MahmoudH-22/Smart_Home/docs/reports/fig/c_xray.png

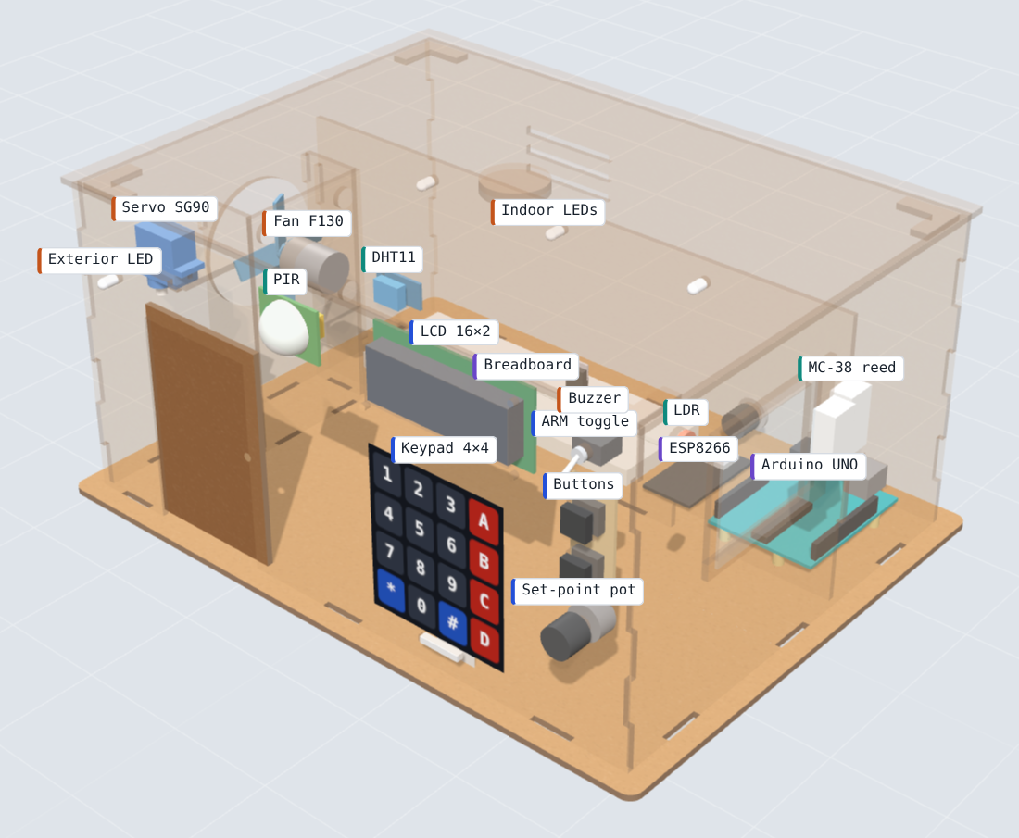
docs/reports/fig/c_xray.png
