MahmoudH-22/Smart_Home/docs/design/smart_home_3d.html

MCT331s · Mechatronic System Integration · Project 1

# Smart Home Prototype

3 mm MDF laser-cut · 300 × 220 mm footprint · Arduino UNO

Team: Mahmoud Hisham 2400844 · Ziad Hany 2301401 · Ahmed Hany 2400311 · Moatasem Mohamed 2400732

A · Gable roof (hinged) B · Flat lid · chosen

ISO FRONT BACK LEFT RIGHT TOP

Dimensions Labels X-ray Open roof Ortho

Explode

Isometric

### LCD 16×2 I2C 0x27

Code ––––Default code 1234, then #

### Security PIR · MC-38 · buzzer

Security mode (toggle)Disarmed

Window (MC-38)Closed

Motion near the doorWalk past

AlarmMute / reset

### Lighting & climate LDR · DHT11 · pot

Ambient light (LDR)70 %

Indoor light overrideAuto

Room temperature (DHT11)26 °C

Fan set-point (knob)30 °C

### System state

### Event log alerts → recipients
