MahmoudH-22/Smart_Home/docs/reports/fig/c_exploded.png

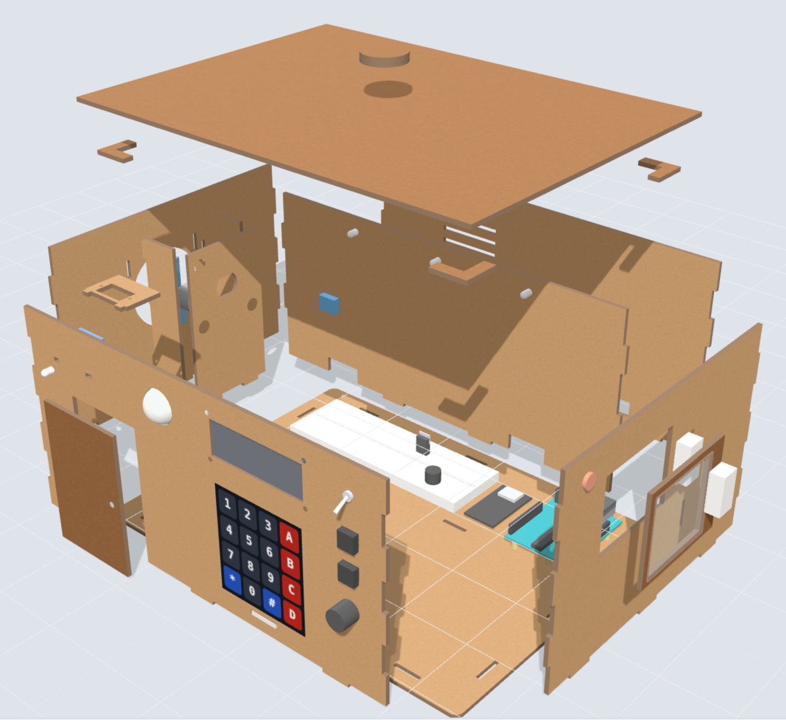
docs/reports/fig/c_exploded.png
