MahmoudH-22/Smart_Home/docs/reports/fig/c_front.png

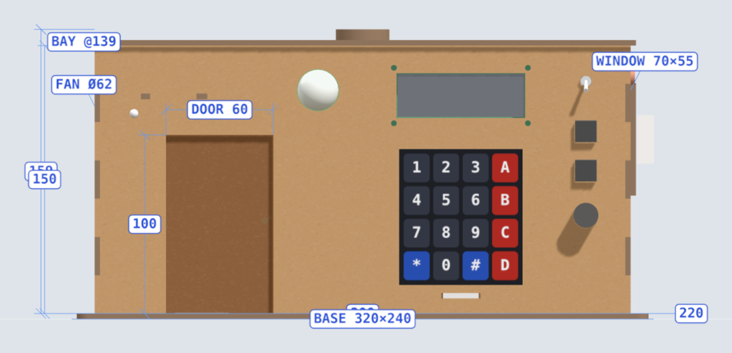
docs/reports/fig/c_front.png
