MahmoudH-22/Smart_Home/docs/reports/fig/c_iso.png

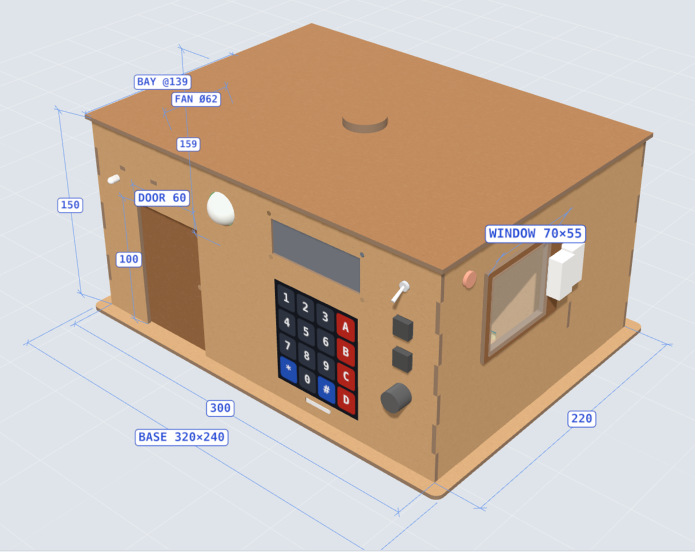
docs/reports/fig/c_iso.png
