MahmoudH-22/Smart_Home/docs/reports/fig/c_left.png

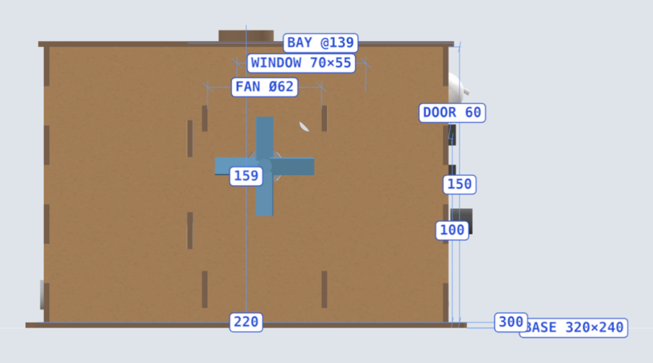
docs/reports/fig/c_left.png
