MahmoudH-22/Smart_Home/docs/reports/fig/c_right.png

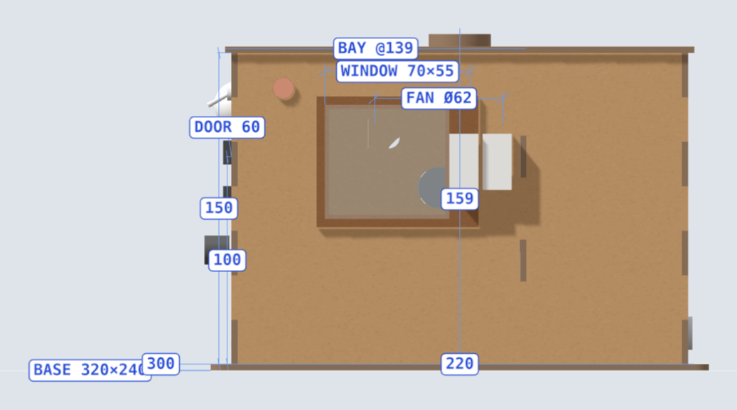
docs/reports/fig/c_right.png
