MahmoudH-22/Smart_Home/docs/reports/fig/c_top.png

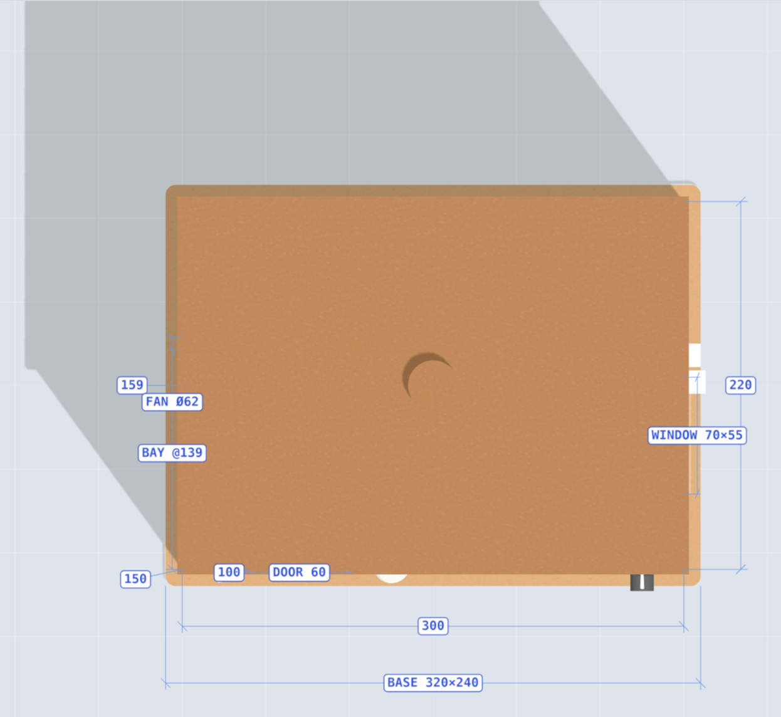
docs/reports/fig/c_top.png
