MahmoudH-22/Smart_Home/docs/BOM.md

# Bill of Materials

Classified as the report requires: **Sensor**, **Actuator**, **Information processing**, **Mechanical**.
Prices are in EGP from the purchase receipt (20 Oct 2026).

## Bought

| # | Item | Class | Function | Qty | Unit (EGP) | Total (EGP) |
|---|---|---|---|---|---|---|
| 1 | Arduino UNO R3 (clone) | Information processing | Main controller | 1 | 339.00 | 339.00 |
| 2 | LCD 16×2 blue + I2C module (soldered) | Information processing | Status display | 1 | 130.00 | 130.00 |
| 3 | Matrix keypad 4×4 | Sensor (user input) | Door code entry | 1 | 29.90 | 29.90 |
| 4 | MC-38 magnetic door/window switch (NC) | Sensor | Window open/closed | 1 | 59.90 | 59.90 |
| 5 | DHT11 temperature/humidity module | Sensor | Room temperature | 1 | 49.00 | 49.00 |
| 6 | LDR photoresistor 10 mm | Sensor | Ambient light level | 1 | 11.90 | 11.90 |
| 7 | Toggle switch 3-pin, 2-position | Sensor (user input) | Security ARM switch | 1 | 11.90 | 11.90 |
| 8 | Push button 12×12×7.3 mm (4-pin) | Sensor (user input) | Light override / alarm mute | 3 | 3.25 | 9.75 |
| 9 | Omron button cap 12×12 (black) | Mechanical | Button caps | 3 | 1.75 | 5.25 |
| 10 | Servo SG90 180° | Actuator | Door motion | 1 | 80.00 | 80.00 |
| 11 | DC motor 5 V F130 | Actuator | Fan | 1 | 12.90 | 12.90 |
| 12 | Plastic propeller 4 blades 56 mm | Mechanical | Fan blade | 1 | 18.90 | 18.90 |
| 13 | Buzzer 5 V | Actuator | Alarm sound | 1 | 7.90 | 7.90 |
| 14 | White LED 5 mm | Actuator | Indoor + exterior lights | 10 | 0.47 | 4.70 |
| 15 | Resistor 220 Ω ¼ W | Electrical | LED current limit | 10 | 0.20 | 2.00 |
| 16 | Breadboard 830 tie-point (split rails) | Electrical | Prototype wiring | 1 | 40.00 | 40.00 |
| 17 | Breadboard jumper kit (140, U-shape) | Electrical | Short breadboard links | 1 | 54.90 | 54.90 |
| 18 | Jumper wires 40 cm female-female | Electrical | Off-board wiring | 40 | 1.75 | 70.00 |
| 19 | Jumper wires 20 cm male-male | Electrical | Breadboard wiring | 40 | 0.78 | 31.20 |
| 20 | Heat-shrink bag (164 pcs) | Electrical | Insulating joints | 1 | 64.90 | 64.90 |
| 21 | Component storage box 230×160×60 | - | Parts storage | 1 | 94.90 | 94.90 |
| | **Receipt total** | | | | | **1,128.90** |

## Structure (laser-cut)

| Item | Material | Qty |
|---|---|---|
| House panels (19 parts, 14 designs) | 3 mm MDF, 2 sheets 600×400 | 2 sheets |
| Wood glue | PVA | 1 |

## Still to buy

| Item | Class | For | Qty |
|---|---|---|---|
| PIR motion sensor HC-SR501 | Sensor | Exterior light on motion | 1 |
| Potentiometer 10 kΩ (panel, with knob) | Sensor (user input) | Fan set-point | 1 |
| Resistor 10 kΩ | Electrical | LDR voltage divider | 2 |
| TIP120 (or 2N2222) + 1N4007 + 1 kΩ | Electrical (driver) | Fan motor driver | 1 set |
| PCF8574 I2C I/O module | Information processing | Keypad on the I2C bus (frees 8 pins) | 1 |
| ESP8266 (ESP-01 + adapter, or NodeMCU) | Information processing | Phone alerts (Wi-Fi) | 1 |
| 5 V 2 A adapter + panel DC jack | Power | Servo + fan supply | 1 |
| M3 brass standoffs + screws | Mechanical | Arduino / LCD mounting | 4 + 8 |
| Mini hinge 25 mm | Mechanical | Window | 1 |
| 2 mm clear acrylic (optional) | Mechanical | Window glazing | 62×57 mm |
| Veroboard | Electrical | Final soldered wiring | 1 |
