MahmoudH-22/Smart_Home/hardware/laser_dxf/parts/fanplate_x1.dxf

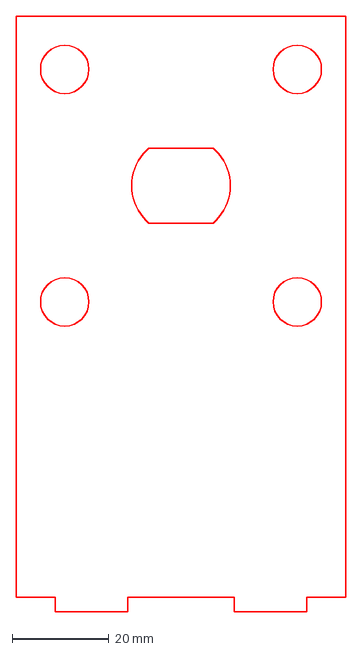
[picture p16: CAD file, 2026-10-25]
hardware/laser_dxf/parts/fanplate_x1.dxf
68.0 x 123.0 mm
