MahmoudH-22/Smart_Home/hardware/laser_dxf/sheet_1_of_2_600x400.dxf

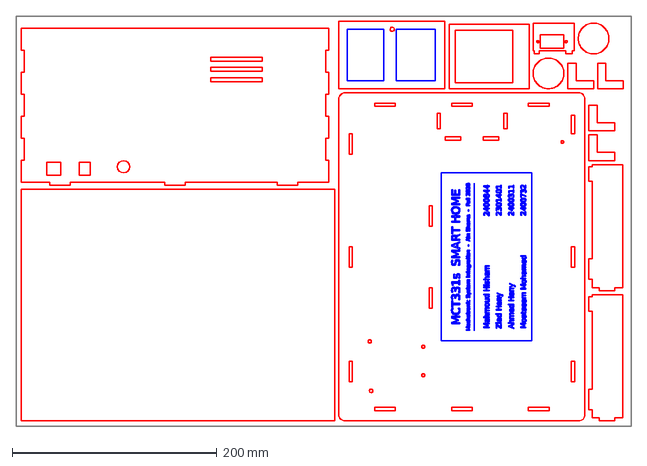
[picture p17: CAD file, 2026-10-25]
hardware/laser_dxf/sheet_1_of_2_600x400.dxf
600.0 x 400.0 mm
