MahmoudH-22/Smart_Home/hardware/laser_dxf/parts/lid_x1.dxf

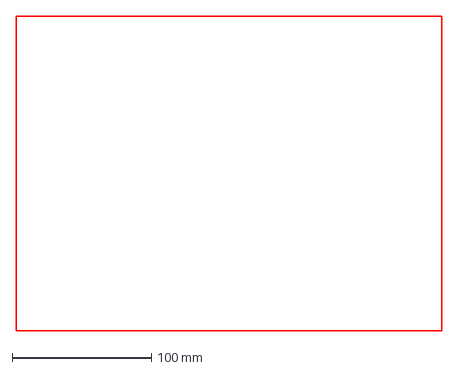
[picture p18: CAD file, 2026-10-25]
hardware/laser_dxf/parts/lid_x1.dxf
306.0 x 226.0 mm
