MahmoudH-22/Smart_Home/hardware/laser_dxf/sheet_2_of_2_600x400.dxf

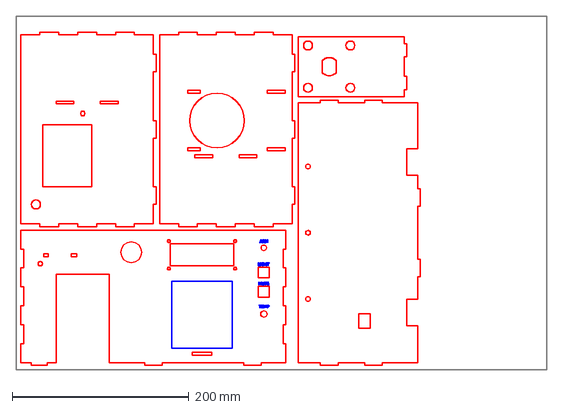
[picture p19: CAD file, 2026-10-25]
hardware/laser_dxf/sheet_2_of_2_600x400.dxf
600.0 x 400.0 mm
