MahmoudH-22/Smart_Home/hardware/laser_dxf/parts/right_x1.dxf

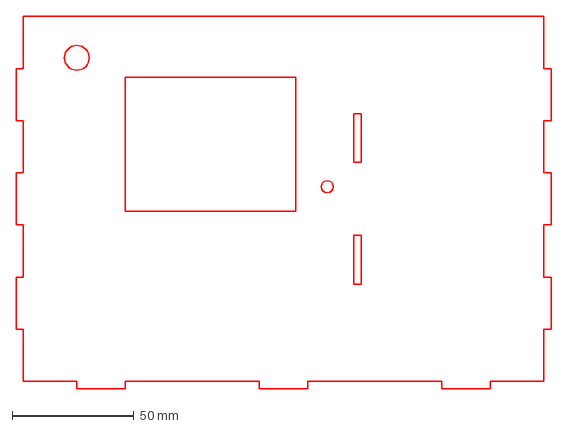
[picture p20: CAD file, 2026-10-25]
hardware/laser_dxf/parts/right_x1.dxf
220.0 x 153.0 mm
