MahmoudH-22/Smart_Home/hardware/laser_dxf/parts/shelf_x1.dxf

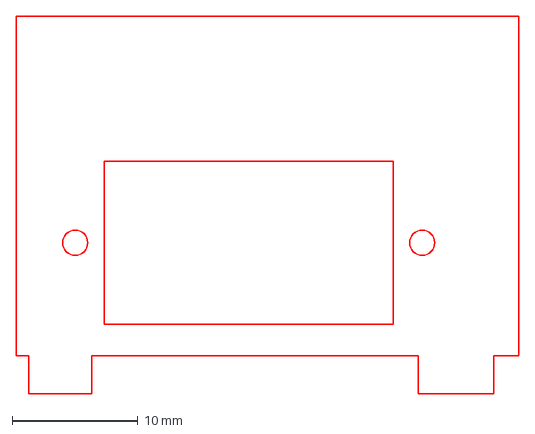
[picture p21: CAD file, 2026-10-25]
hardware/laser_dxf/parts/shelf_x1.dxf
40.0 x 30.0 mm
