MahmoudH-22/Smart_Home/hardware/laser_dxf/parts/door_x1.dxf

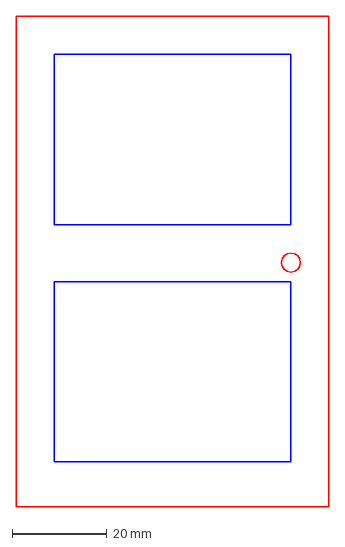
[picture p22: CAD file, 2026-10-25]
hardware/laser_dxf/parts/door_x1.dxf
66.0 x 103.5 mm
