MahmoudH-22/Smart_Home/hardware/laser_dxf/parts/locator_x4.dxf

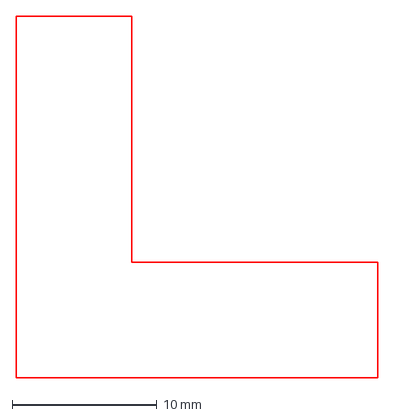
[picture p23: CAD file, 2026-10-25]
hardware/laser_dxf/parts/locator_x4.dxf
25.0 x 25.0 mm
