MahmoudH-22/Smart_Home/hardware/laser_dxf/parts/partition_x1.dxf

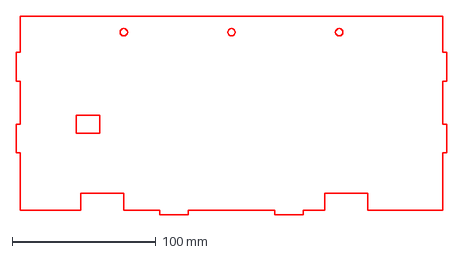
[picture p24: CAD file, 2026-10-25]
hardware/laser_dxf/parts/partition_x1.dxf
300.0 x 138.0 mm
