MahmoudH-22/Smart_Home/hardware/laser_dxf/parts/fanrib_x2.dxf

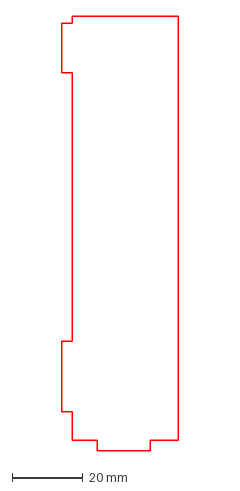
[picture p25: CAD file, 2026-10-25]
hardware/laser_dxf/parts/fanrib_x2.dxf
33.0 x 123.0 mm
