MahmoudH-22/Smart_Home/hardware/laser_dxf/parts/knob_x2.dxf

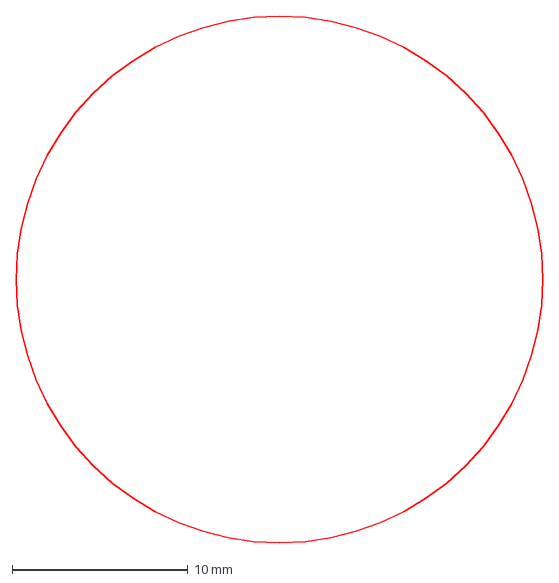
[picture p26: CAD file, 2026-10-25]
hardware/laser_dxf/parts/knob_x2.dxf
30.0 x 30.0 mm
