MahmoudH-22/Smart_Home/hardware/laser_dxf/parts/sash_x1.dxf

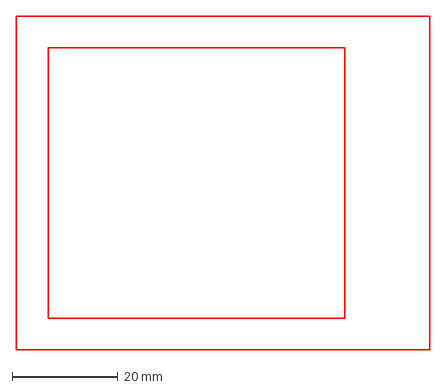
[picture p27: CAD file, 2026-10-25]
hardware/laser_dxf/parts/sash_x1.dxf
78.0 x 63.0 mm
