MahmoudH-22/Smart_Home/hardware/laser_dxf/parts/back_x1.dxf

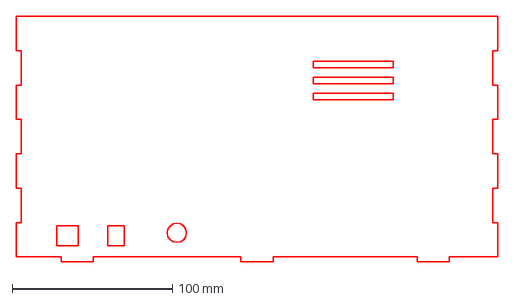
[picture p30: CAD file, 2026-10-25]
hardware/laser_dxf/parts/back_x1.dxf
300.0 x 153.0 mm
