MahmoudH-22/Smart_Home/hardware/laser_dxf/parts/base_x1.dxf

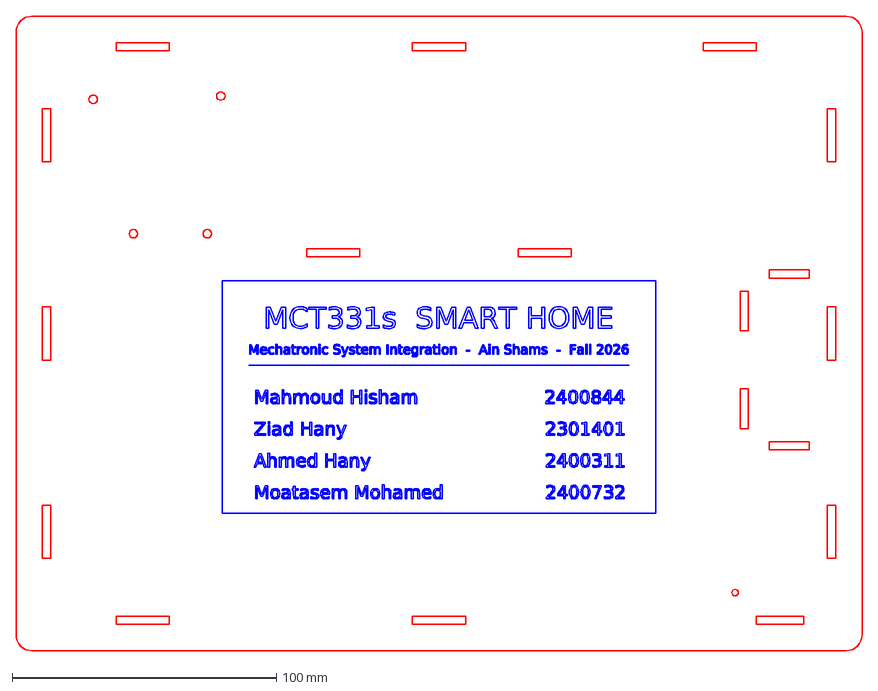
[picture p31: CAD file, 2026-10-25]
hardware/laser_dxf/parts/base_x1.dxf
320.0 x 240.0 mm
