MahmoudH-22/Smart_Home/hardware/wiring/Wiring_Guide.pdf

## MCT331s · Mechatronic System Integration · Project 1

# دليل التوصيل — Home Smart

كل التوصيالت اليل عملناها لحد دلوقيت، خطوة بخطوة، بالصور ورقم كل pin.

اليل في الدليل: الـ Buzzer لوحده ← الشاشة LCD لوحدها ← التوصيل الكامل )Buzzer + LCD + حساس الشباك -38MC).

Mahmoud Hisham | 2400844
Ziad Hany | 2301401
Ahmed Hany | 2400311
Moatasem Mohamed | 2400732

Ain Shams University · Faculty of Engineering · 21 Oct 2026

## 0( قبل ما تبدأ

### الحاجات المطلوبة

USB | كابل | + Arduino UNO

Breadboard 830

I2C backpack | عليها | LCD 16×2 | شاشة

Buzzer 5V

حساس شباك مغناطييس-38MC( قطعتني: حساس بسلكني +

مغناطيس(

سلوك M-M :jumper( ذكر-ذكر( و F-F( أنىث-أنىث(

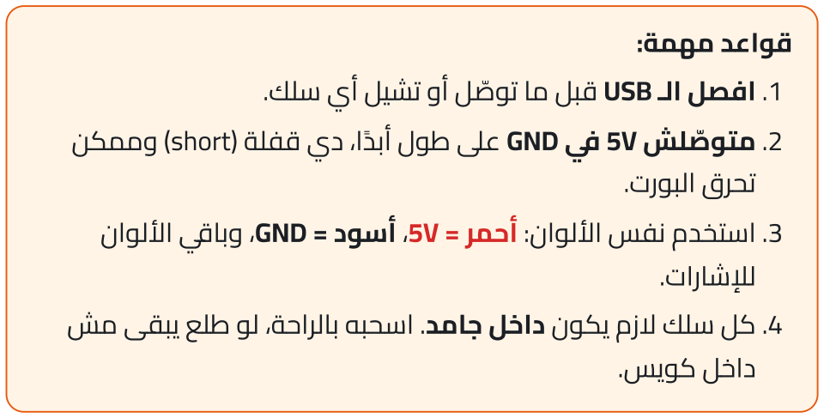
[picture p32: figure]
قواعد مهمة:; تحرق البورت.; لإلشارات.; داخل كويس.

.1 افصل الـ USB قبل ما توّصل أو تشيل أي سلك.

.2 متوّصلشV5 في GND عىل طول أبًدا، دي قفلة )short )وممكن

.3 استخدم نفس األلوان: أحمر = V،5 أسود = GND، وباقي األلوان

.4 كل سلك الزم يكون داخل جامد. اسحبه بالراحة، لو طلع يبقى مش

### إزاي تعمل سلك Female-Male

رجول الشاشة ذكر واألردوينو أنىث، فمحتاج سلك ذكر من ناحية وأنىث من

الناحية التانية. لو معندكش، د ّخل سلك M-M جوه طرف سلك F-F، فيبقى

عندك سلك ذكر-أنىث. لّف عىل الوصلة شوية رشيط عشان متف ّكش.

اقرا مكان الخرم كده: الحرف هو الصف )j–a )والرقم هو العمود )1–

30(. يعين 17j = صف j، عمود .17 و − Rail = الصف األزرق اليل تحت.

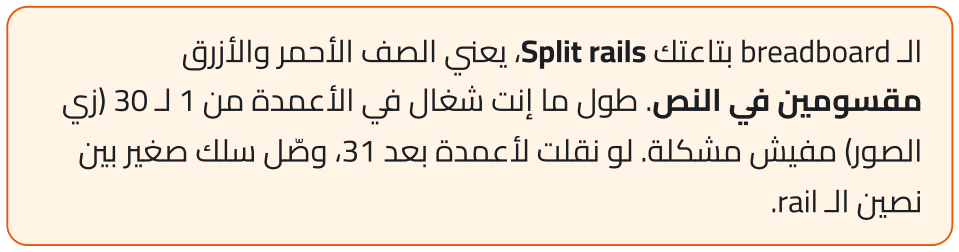
[picture p33: figure]
نصني الـ rail.

الـ breadboard بتاعتك rails Split، يعين الصف األحمر واألزرق

مقسومني في النص. طول ما إنت شغال في األعمدة من 1 لـ 30 )زي

الصور( مفيش مشكلة. لو نقلت ألعمدة بعد ،31 وّصل سلك صغري بني

## 0( الـ breadboard متوصلة من جوه إزاي

أهم حاجة تفهمها قبل أي توصيل: الخرمني اليل في نفسالعمود )في نفس النص( متوصلني ببعض، فلو حطيت رجل قطعة وسلك في نفس العمود يبقوا

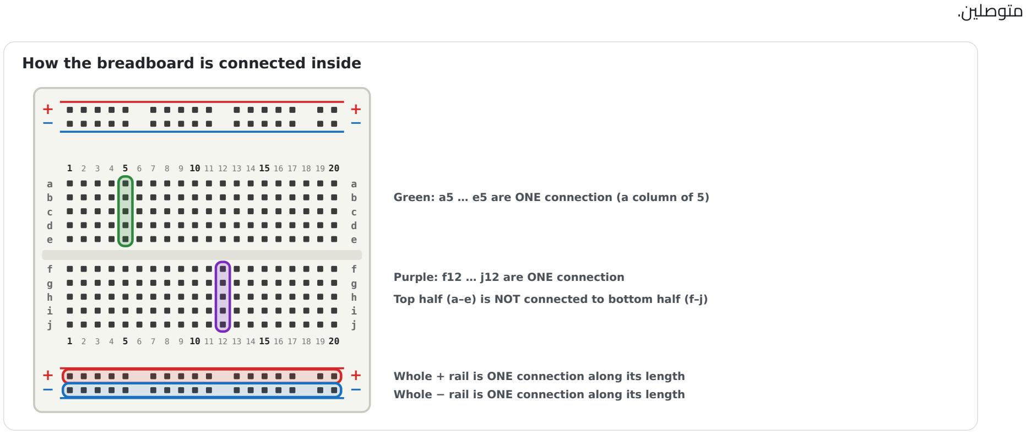
[picture p34: figure]
متوصلني.; How the breadboard is connected inside; Purple: f12 … j12 are ONE connection

Green: a5 … e5 are ONE connection (a column of 5)

Top half (a–e) is NOT connected to bottom half (f–j)

Whole + rail is ONE connection along its length Whole − rail is ONE connection along its length

## 1( الـ Buzzer لوحده

## 1) Buzzer alone — D8 → Buzzer(+) , Buzzer(−) → GND

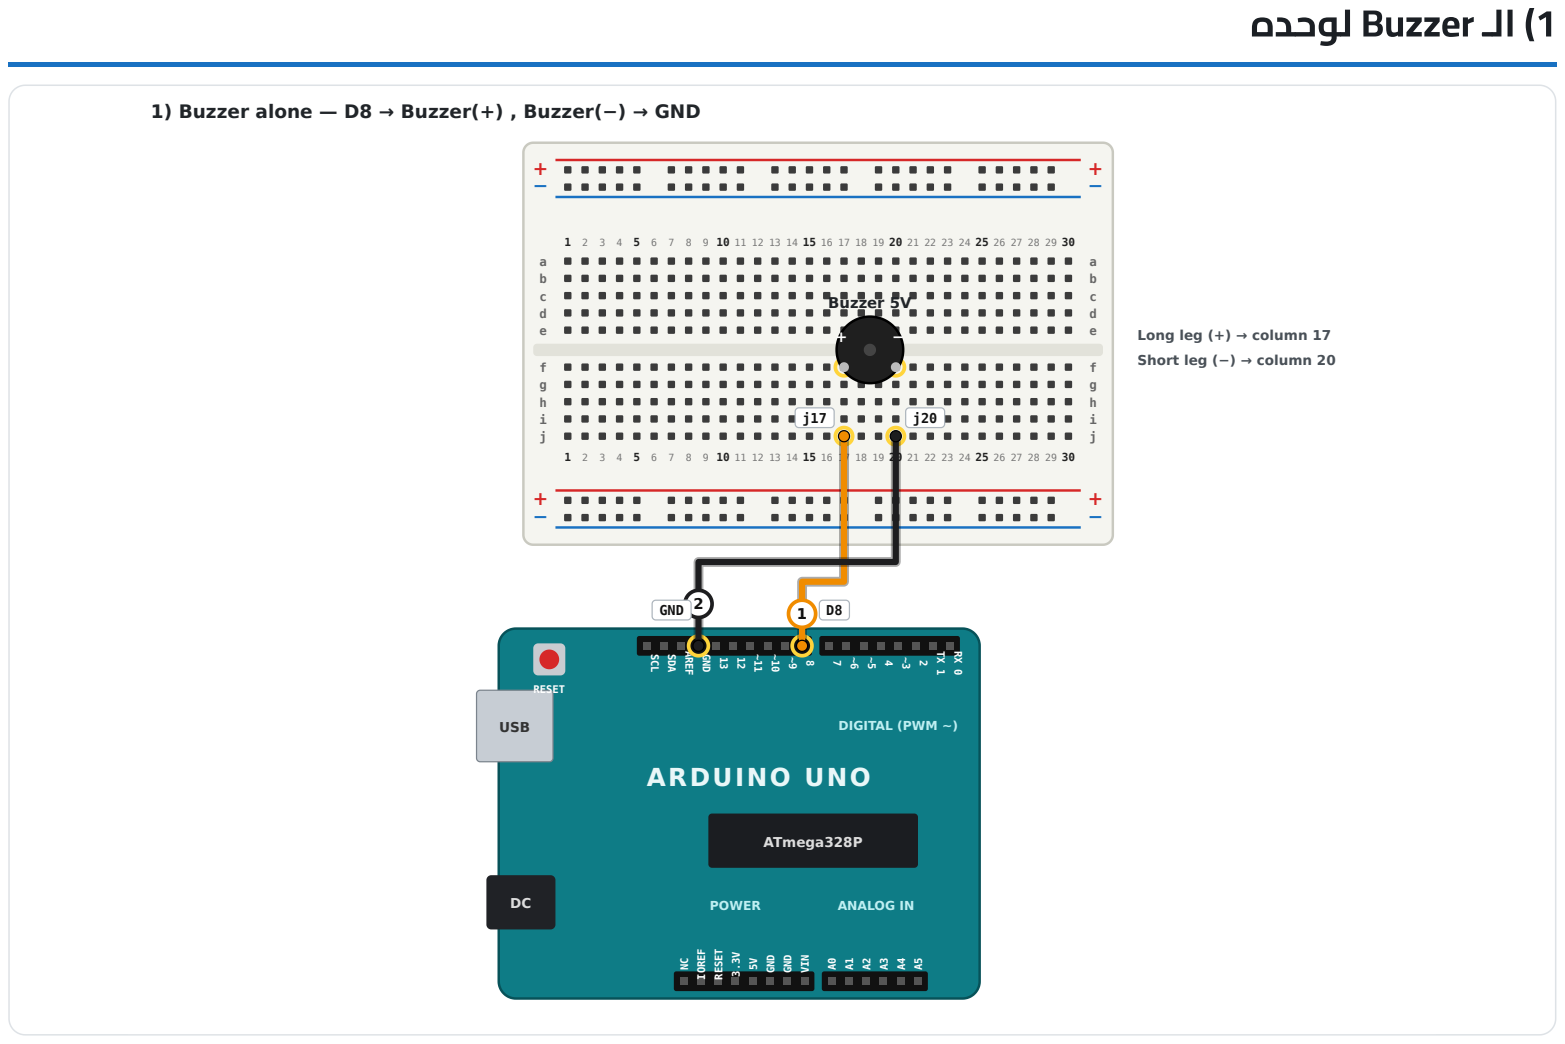
[picture p35: page 4]
USB; ATmega328P; ARDUINO UNO; RESET; SCL; SDA; AREF; GND; IOREF; VIN; DIGITAL (PWM ~); POWER; ANALOG IN; Buzzer 5V; 2 GND

Long leg (+) → column 17
Short leg (−) → column 20

## 1( الـ Buzzer لوحده — الخطوات

### حط الـ buzzer عىل الـ breadboard

.1 بص عىل رجلني الـ buzzer: الطويلة = + والقصرية = .− وغالًبا عالمة +

مكتوبة عليه من فوق.

.2 ل الرجل الطويلة )+( في 17f، والقصرية )−( في 20f.
د ّخ

### السلوك

# من )From )إىل )To)

لون

السلك

مالحظة

## Arduino D8 1

## Breadboard 17j برتقايل

نفس العمود اليل فيه رجل

الـ + )الطويلة( بتاعة الـ

f17 في buzzer

2

## Breadboard

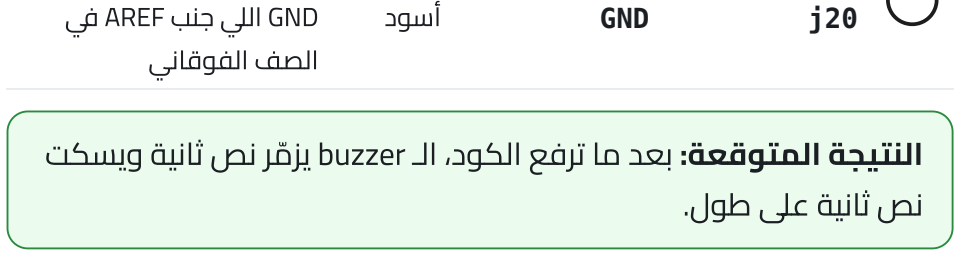
[picture p36: figure]
GND اليل جنب AREF في; الصف الفوقاني; نص ثانية عىل طول.

j20

## Arduino GND أسود

نفس العمود اليل فيه رجل

الـ − )القصرية( في 20f. الـ

النتيجة المتوقعة: بعد ما ترفع الكود، الـ buzzer يزّمر نص ثانية ويسكت

لو مش بزيّمر: اقلب رجلني الـ buzzer، واتأكد إن السلك الربتقايل في 8D

### كود التجربة

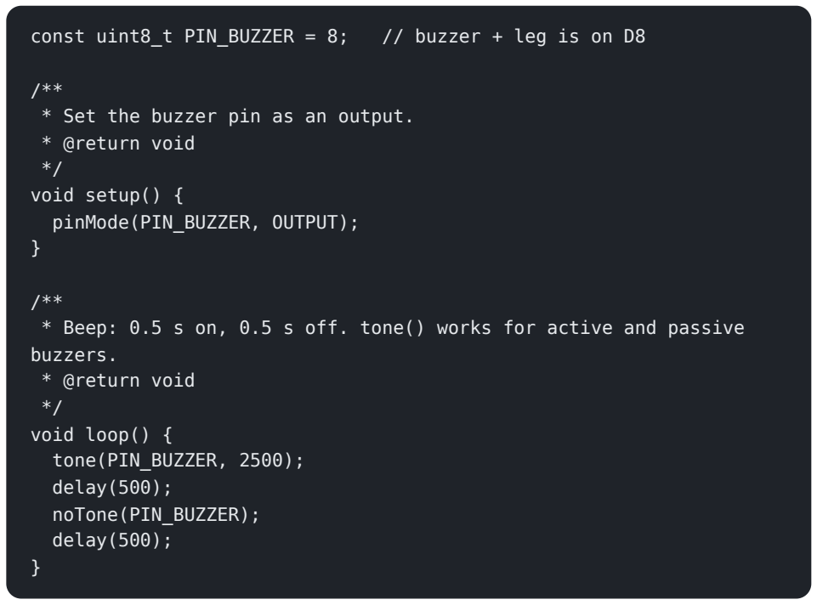
[picture p37: figure]
/** * Set the buzzer pin as an output. * @return void */ void setup() { pinMode(PIN_BUZZER, OUTPUT);; buzzers. * @return void */ void loop() { tone(PIN_BUZZER, 2500); delay(500); noTone(PIN_BUZZER); delay(500);

### const uint8_t PIN_BUZZER = 8; // buzzer + leg is on D8

### * Beep: 0.5 s on, 0.5 s off. tone() works for active and passive

## 2( الشاشة LCD لوحدها

## 2) LCD 16×2 I2C alone — GND→GND , VCC→5V , SDA→A4 , SCL→A5

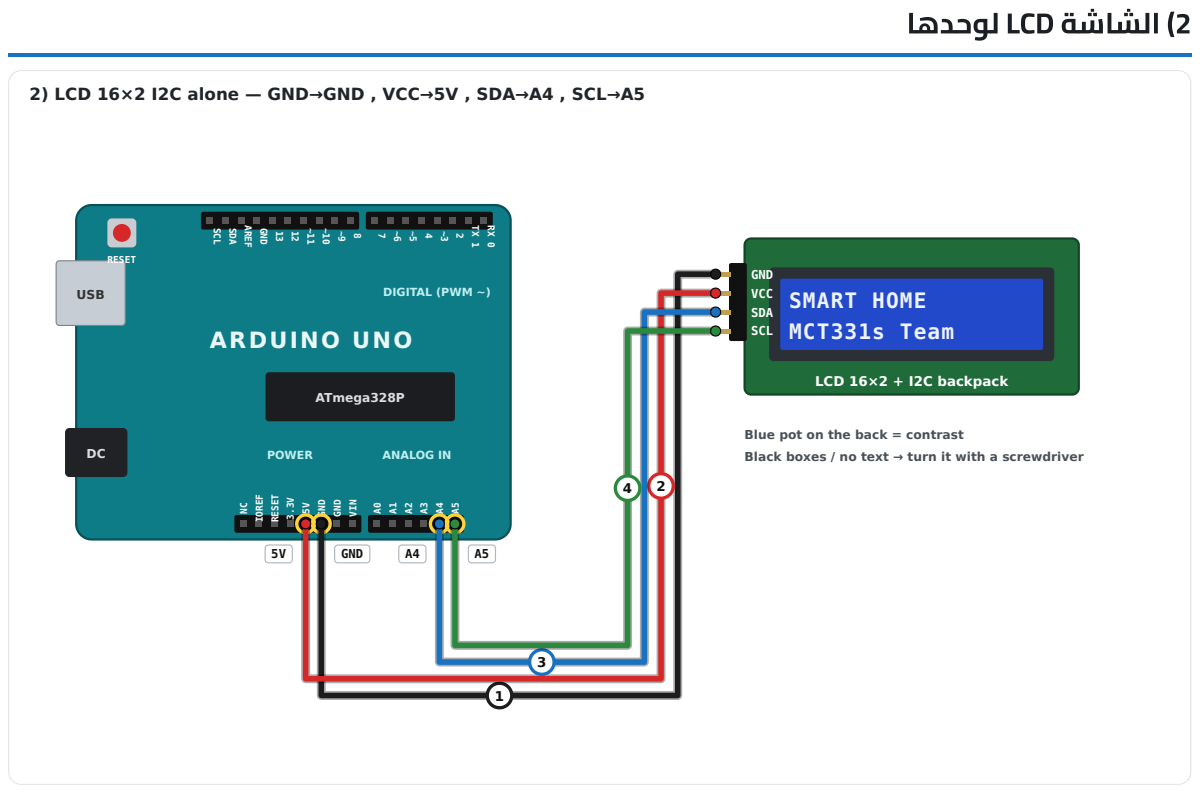
[picture p38: page 6]
USB; ATmega328P; ARDUINO UNO; RESET; SCL; SDA; AREF; GND; IOREF; VIN; DIGITAL (PWM ~); POWER; ANALOG IN; SMART HOME MCT331s Team; LCD 16×2 + I2C backpack; GND VCC SDA SCL

Blue pot on the back = contrast
Black boxes / no text → turn it with a screwdriver

## 2( الشاشة LCD لوحدها — الخطوات

الشاشة متوصلة بـ 4 سلوك بسعن طريق الـ backpack C2I( البوردة

الصغرية اليل ورا الشاشة(. الـ 4 رجول مكتوب جنبهم أساميهم.

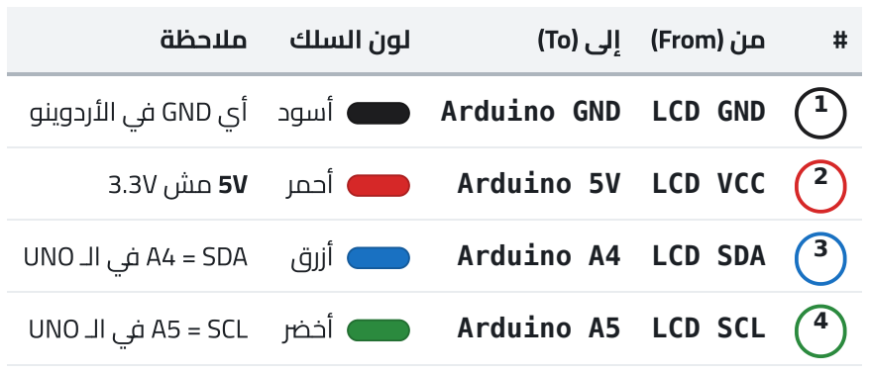
[picture p39: figure]
# من )From )إىل )To )لون السلك مالحظة; أحمر; Arduino 5V LCD VCC

1 األردوينو | في GND | أي | أسود | Arduino GND LCD GND
3 UNO الـ | في A4 = SDA | أزرق | Arduino A4 LCD SDA
4 UNO الـ | في A5 = SCL | أخرض | Arduino A5 LCD SCL

### الخطوات

.1 ل الـ library: في الـ IDE Arduino افتح Manager Library وابحث

ّز
ن
ودوس | Frank de Brabander | بتاعة | LiquidCrystal I2C عن

.Install

.2 ارفع الـ Scanner C2I وافتح الـ Monitor Serial عىل .9600 هيكتب

# .0x3F أو Found device at 0x27

.3 ارفع كود تجربة الشاشة، وحط فيه نفس الرقم اليل طلعلك.

لو الشاشة منّورة بس فيها مربعات سودا، أو مفيش كتابة: لّف | .4 الـ

pot األزرق اليل ورا الشاشة بمفك لحد ما الكتابة تبان.

النتيجة المتوقعة: الشاشة تكتب HOME SMART في السطر
األول و Team s331MCT في التاني.

### I2C Scanner الـ

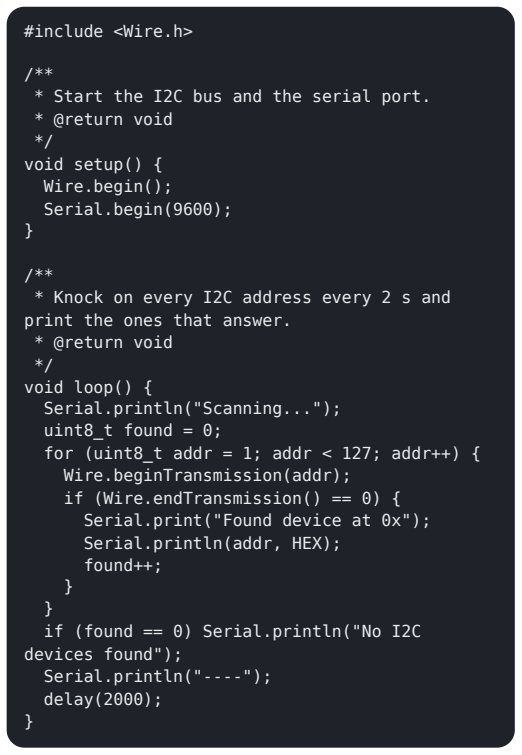
[picture p40: figure]
#include <Wire.h>; * @return void */ void setup() { Wire.begin(); Serial.begin(9600);; print the ones that answer. * @return void */ void loop() { Serial.println("Scanning..."); uint8_t found = 0;; Wire.beginTransmission(addr); if (Wire.endTransmission() == 0) { Serial.print("Found device at 0x"); Serial.println(addr, HEX); found++;; } if (found == 0) Serial.println("No I2C devices found"); Serial.println("----"); delay(2000);

* Start the I2C bus and the serial port.

* Knock on every I2C address every 2 s and

for (uint8_t addr = 1; addr < 127; addr++) {

### كود تجربة الشاشة

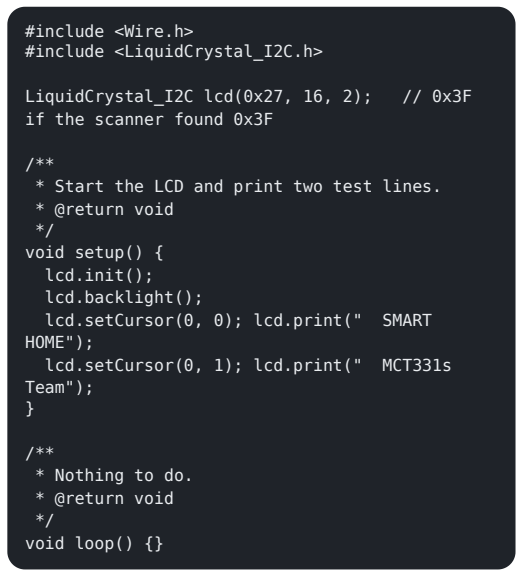
[picture p41: figure]
#include <Wire.h> #include <LiquidCrystal_I2C.h>; LiquidCrystal_I2C lcd(0x27, 16, 2);; if the scanner found 0x3F; * @return void */ void setup() { lcd.init(); lcd.backlight(); lcd.setCursor(0, 0); lcd.print(" SMART HOME"); lcd.setCursor(0, 1); lcd.print(" MCT331s Team"); }; /** * Nothing to do. * @return void */ void loop() {}

* Start the LCD and print two test lines.

## 3( التوصيل الكامل — Buzzer + LCD + حساس الشباك

### 3) Full system — LCD + Buzzer + MC-38 window sensor

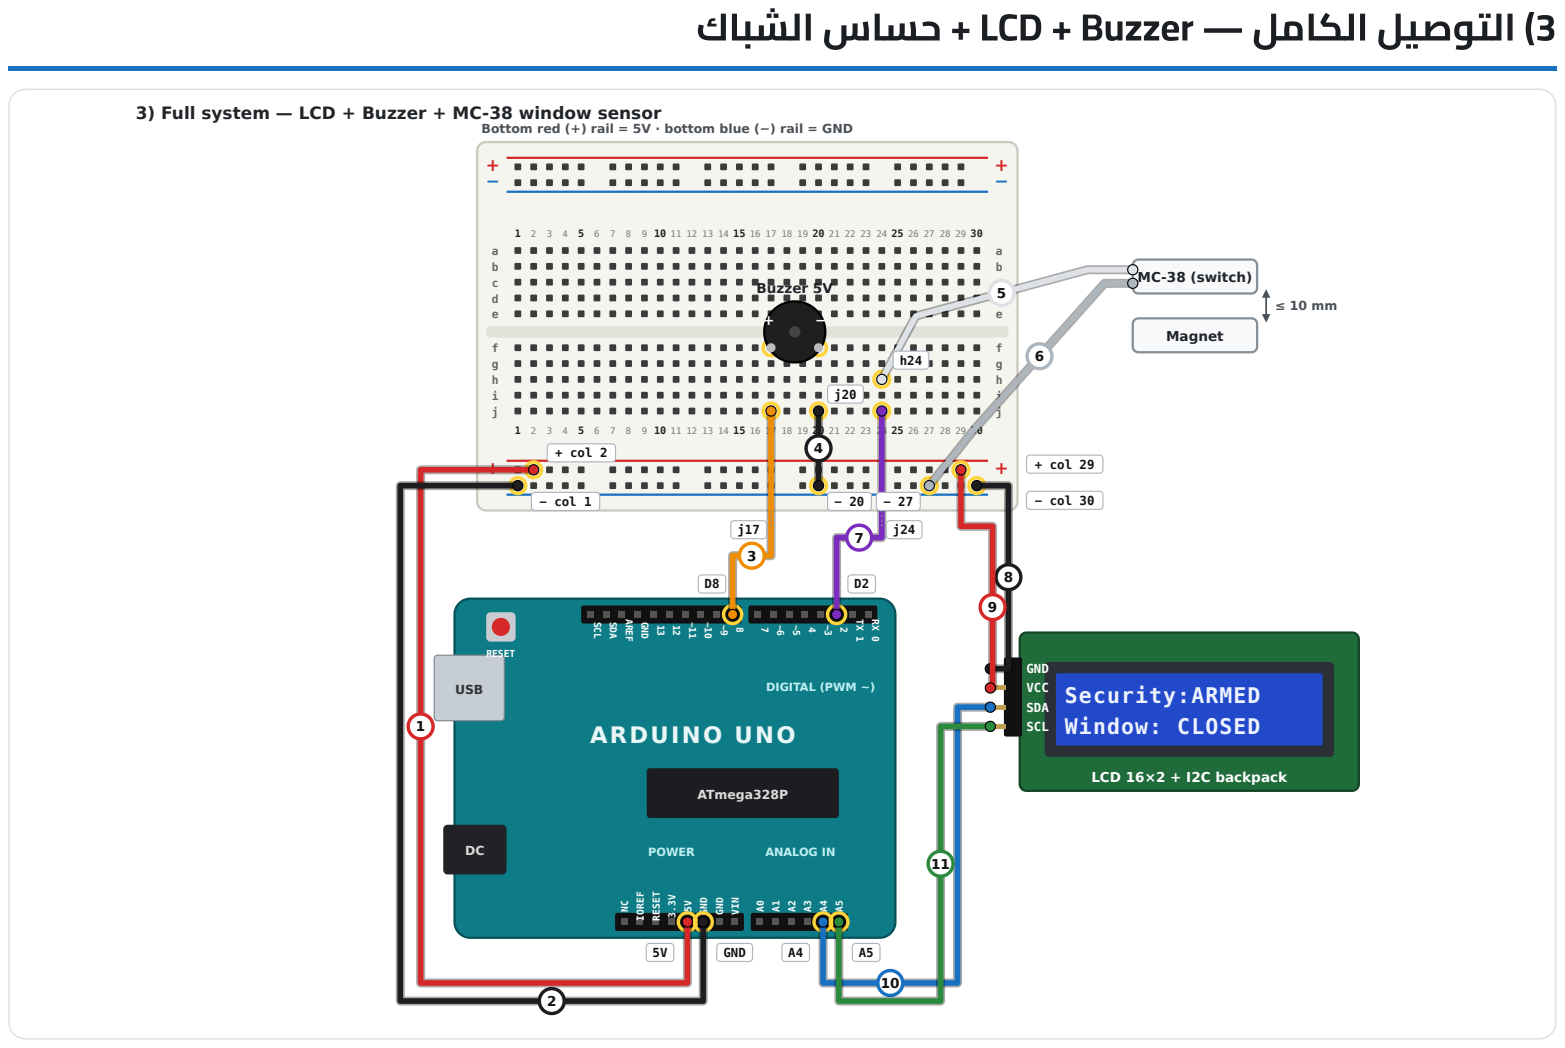
[picture p42: page 9]
USB; ATmega328P; ARDUINO UNO; RESET; SCL; SDA; AREF; GND; IOREF; VIN; DIGITAL (PWM ~); POWER; ANALOG IN; Buzzer 5V; Security:ARMED Window: CLOSED; LCD 16×2 + I2C backpack; GND VCC SDA SCL; MC-38 (switch); Magnet; + col 2; − col 1; + col 29; − col 30

Bottom red (+) rail = 5V · bottom blue (−) rail = GND

## 3( التوصيل الكامل — جدول السلوك

هنا الكهربا )V5 و GND )بتطلع من األردوينو للـ breadboard األول، وكل حاجة بتاخد منها. األرقام نفس األرقام اليل عىل السلوك في الصورة.

# من )From )إىل )To )لون السلك مالحظة

V5 Arduino) 2 col (+ Rail أحمر الصف األحمر + اليل تحت. أي خرم فيه ينفع | 1
GND Arduino) 1 col (− Rail أسود الصف األزرق − اليل تحت. أي خرم فيه ينفع | 2
8D Arduino 17j برتقايل رجل الـ buzzer الـ + )الطويلة( في 17f | 3
20j) 20 col (− Rail أسود رجل الـ buzzer الـ − )القصرية( في 20f | 4

5 1 wire -38MC 24h سلك الحساس سلك من سلكني الـ -38MC( مش مهم أنهي واحد(

2 wire -38MC) 27 col (− Rail سلك الحساس السلك التاني عىل طول عىل الـ GND | 6
2D Arduino 24j بنفسجي نفس عمود سلك الحساس األول )24( | 7
8 male-female | سلك | أسود | Rail − (col 30) | LCD GND
9 male-female | سلك | أحمر | Rail + (col 29) | LCD VCC
SDA LCD 4A Arduino أزرق عىل األردوينو عىل طول | 10
SCL LCD 5A Arduino أخرض عىل األردوينو عىل طول | 11

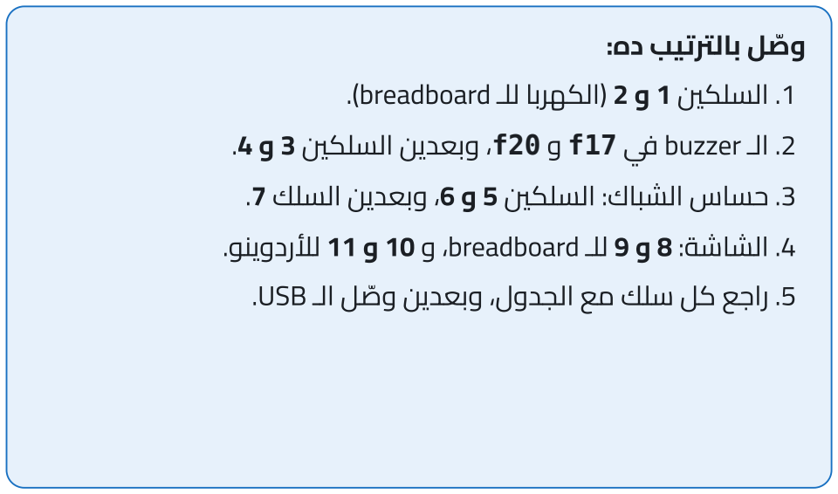
[picture p43: figure]
وّصل بالرتتيب ده:

.1 السلكني 1 و 2 )الكهربا للـ breadboard).

.2 الـ buzzer في 17f و 20f، وبعدين السلكني 3 و .4

.3 حساس الشباك: السلكني 5 و ،6 وبعدين السلك .7

.4 الشاشة: 8 و 9 للـ breadboard، و 10 و 11 لألردوينو.

.5 راجع كل سلك مع الجدول، وبعدين وّصل الـ USB.

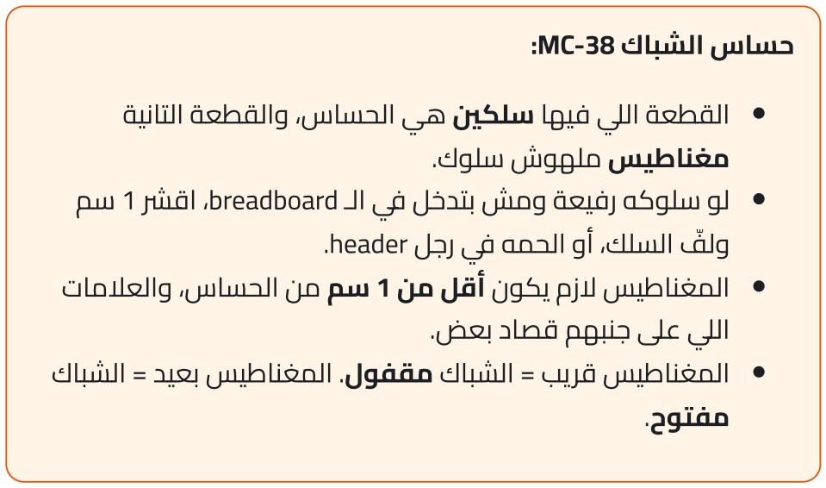
[picture p44: figure]
حساس الشباك -38MC:; مغناطيسملهوش سلوك.; ولّف السلك، أو الحمه في رجل header.; اليل عىل جنبهم قصاد بعض.; مفتوح.

القطعة اليل فيها سلكني هي الحساس، والقطعة التانية

لو سلوكه رفيعة ومش بتدخل في الـ breadboard، اقرش 1 سم

المغناطيس الزم يكون أقل من 1 سم من الحساس، والعالمات

المغناطيس قريب = الشباك مقفول. المغناطيس بعيد = الشباك

## 3( التوصيل الكامل — الكود

#include <Wire.h>

#include <LiquidCrystal_I2C.h>

// ================= settings =================
const uint8_t LCD_ADDR | = 0x27; | // the address
the scanner found
const uint8_t PIN_REED | = 2; | // MC-38 -> D2 +
GND
const uint8_t PIN_BUZZER | = 8; | // buzzer + ->
D8
const uint8_t PIN_ARM | = 7; | // toggle middle
-> D7, side -> GND (later)
const bool | ALWAYS_ARMED | = true; | // true = no
toggle needed; false when the toggle is wired
const uint8_t REED_OPEN_LEVEL = HIGH; // if the window shows reversed, change to LOW
const unsigned int BUZZ_HZ | = 2500; | // buzzer tone
frequency

LiquidCrystal_I2C lcd(LCD_ADDR, 16, 2);

bool armed = false, windowOpen = false, alarmOn = false;

/**
* Read a pin and return its value only after it stays stable for 30 ms.
* @param pin Arduino pin number
* @param stable last stable value (updated in place) * @param lastRaw last raw reading (updated in place) * @param changedAt time of the last raw change (updated in place)
* @return the stable logic level (HIGH / LOW)
*/
bool readDebounced(uint8_t pin, bool &stable, bool &lastRaw, unsigned long &changedAt) {
bool raw = digitalRead(pin);
if (raw != lastRaw) { lastRaw = raw; changedAt = millis(); }
if (millis() - changedAt > 30) stable = raw; return stable;
}

/**
* Turn the buzzer on (continuous tone) or off. Works for active and passive buzzers.
* @param on true = sound, false = silent
* @return void

*/
void buzzer(bool on) {
static bool isOn = false;
if (on == isOn) return;
isOn = on;
if (on) tone(PIN_BUZZER, BUZZ_HZ); else noTone(PIN_BUZZER);
}

/**
* Write two lines (padded to 16 chars), redrawing only the lines that changed.
* @param l1 row 0 text
* @param l2 row 1 text
* @return void
*/
void lcdWrite(const char *l1, const char *l2) { static char shown[2][17] = { "", "" }; const char *src[2] = { l1, l2 };
for (uint8_t r = 0; r < 2; r++) {
char buf[17];
snprintf(buf, sizeof(buf), "%-16.16s", src[r]); if (strcmp(buf, shown[r]) != 0) { lcd.setCursor(0, r);
lcd.print(buf);
strcpy(shown[r], buf);
}
}
}

/**
* Read the reed + toggle. Window open while armed = buzzer ON; window closed = buzzer OFF.
* @return void
*/
void updateSecurity() {
static bool rS = HIGH, rL = HIGH, aS = HIGH, aL = HIGH;
static unsigned long rT = 0, aT = 0;
static bool lastAlarm = false;

windowOpen = (readDebounced(PIN_REED, rS, rL, rT) == REED_OPEN_LEVEL);
armed = ALWAYS_ARMED || (readDebounced(PIN_ARM, aS, aL, aT) == LOW);
alarmOn = armed && windowOpen;

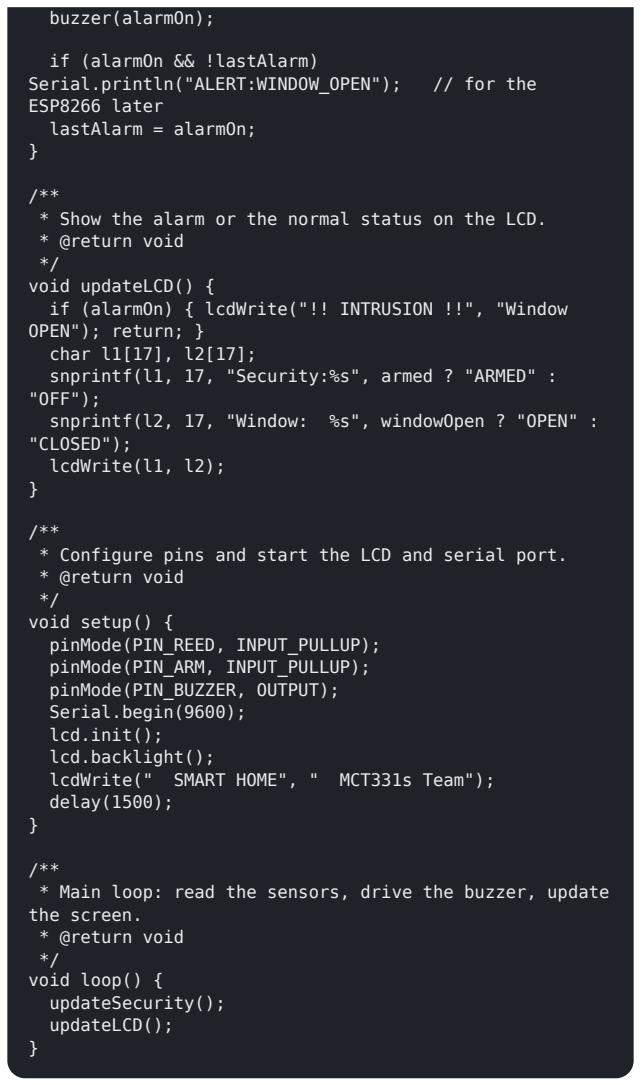
[picture p45: figure]
buzzer(alarmOn);; if (alarmOn && !lastAlarm); Serial.println("ALERT:WINDOW_OPEN");; // for the; ESP8266 later lastAlarm = alarmOn;; * @return void */ void updateLCD() {; OPEN"); return; } char l1[17], l2[17];; "OFF");; "CLOSED"); lcdWrite(l1, l2);; * @return void */ void setup() { pinMode(PIN_REED, INPUT_PULLUP); pinMode(PIN_ARM, INPUT_PULLUP); pinMode(PIN_BUZZER, OUTPUT); Serial.begin(9600); lcd.init(); lcd.backlight();; delay(1500);; the screen. * @return void */ void loop() { updateSecurity(); updateLCD();

* Show the alarm or the normal status on the LCD.

if (alarmOn) { lcdWrite("!! INTRUSION !!", "Window

snprintf(l1, 17, "Security:%s", armed ? "ARMED" :

snprintf(l2, 17, "Window: %s", windowOpen ? "OPEN" :

* Configure pins and start the LCD and serial port.

lcdWrite(" SMART HOME", " MCT331s Team");

* Main loop: read the sensors, drive the buzzer, update

## 3( التوصيل الكامل — التجربة وحل المشاكل

### جّرب بالرتتيب ده

.1 ارفع الكود. الشاشة تكتب HOME SMART ثانية ونص، وبعدين

# .Window: CLOSED و Security:ARMED

.2 ابعد المغناطيسعن الحساس: الـ buzzer يزّمر عىل طول، والشاشة
تكتب !! INTRUSION!! .

.3 قّرب المغناطيس: الـ buzzer يسكت فوًرا، والشاشة ترجع :Window

# .CLOSED

.4 افتح الـ Monitor Serial عىل :9600 كل مرة تفتح الشباك هيكتب

# OPEN_WINDOW:ALERT. ده اليل الـ 8266ESP هيبعته عىل الموبايل

بعدين.

### لو حاجة مششغالة

المشكلة الحل

الشاشة مربعات سودا

لّف الـ pot األزرق، واتأكد إن ADDR_LCD نفس رقم

الـ scanner

الشاشة مطفية السلكني 8 و 9 أو 1 و 2 مش واصلني

الشباك مقلوب )مفتوح

يكتب CLOSED)

## LOW لـ REED_OPEN_LEVEL يّغر

الشباك ثابت مش بيتغرّي

السلك 7 مش في 2D، أو سلك الحساس 5 مش في

نفس عمود 24

الـ buzzer مش بزيّم السلك 3 مش في 8D، أو رجلني الـ buzzer مقلوبني | ر

Upload error / COM

اختار البورت الصح من Port → Tools، واقفل الـ

Monitor Serial قبل الرفع

## 4( ملخص الـ pins

Pin متوصل بإيه الحالة

V5 الـ Rail +( الشاشة VCC )مستخدم

GND الـ Rail −( الشاشة + الـ buzzer + الحساس( مستخدم

مستخدم | ( PCF8574 | طريق | عن keypad الـ | وبعدين | )LCD SDA | A4 (SDA)
مستخدم | LCD SCL | A5 (SCL)

2D حساس الشباك -38MC مستخدم

مستخدم | ( + )Buzzer | D8

3D PIR( حساس الحركة( جاي بعدين

## 7D Toggle الـ ARM( خيل false = ARMED_ALWAYS لما توّصله( جاي بعدين

11D / 6D زرار النور / LEDs النور الداخيل جاي بعدين

0A LDR جاي بعدين

(TX (1D 8266ESP( التنبيه عىل الموبايل( جاي بعدين

Mahmoud Hisham 2400844 · Ziad Hany 2301401 · Ahmed Hany 2400311 · Moatasem Mohamed 2400732
