MahmoudH-22/Smart_Home/hardware/wiring/00_breadboard_explained.png

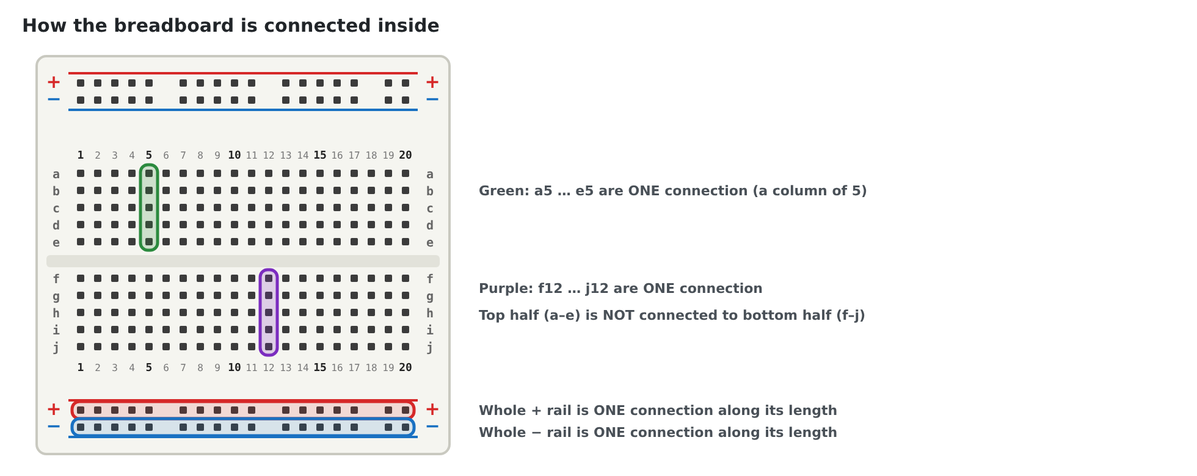
hardware/wiring/00_breadboard_explained.png
