MahmoudH-22/Smart_Home/hardware/wiring/01_buzzer_alone.png

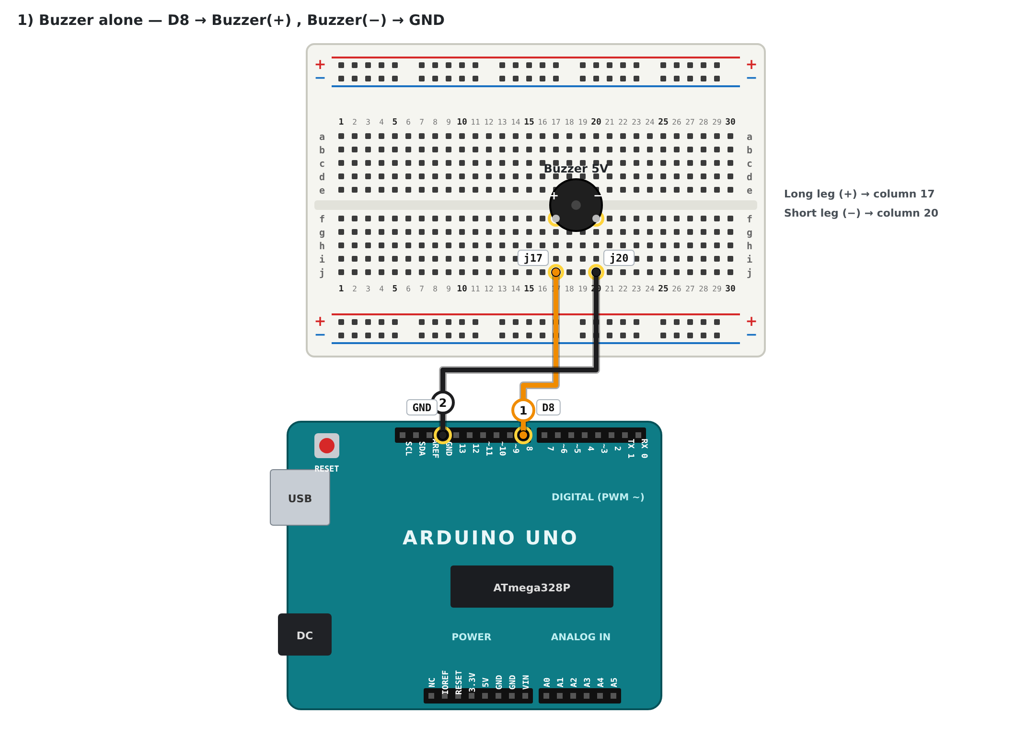
hardware/wiring/01_buzzer_alone.png
