MahmoudH-22/Smart_Home/hardware/wiring/02_lcd_alone.png

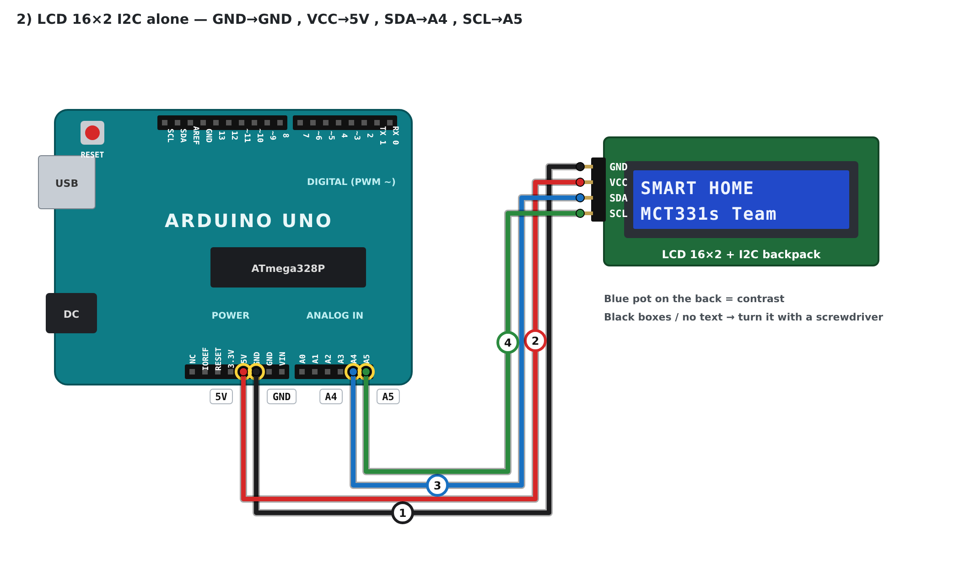
hardware/wiring/02_lcd_alone.png
