MahmoudH-22/Smart_Home/hardware/wiring/03_full_system.png

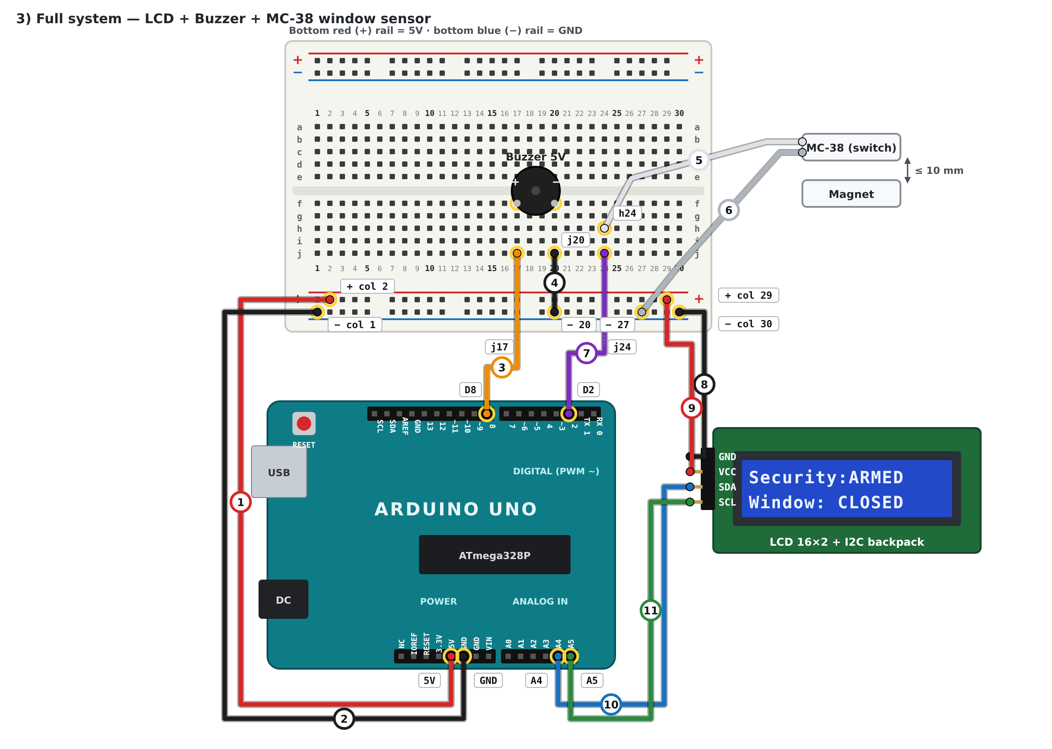
hardware/wiring/03_full_system.png
