MahmoudH-22/Smart_Home/docs/history/2026-10/21-10-2026.md

# 21-10-2026

## Built
- `MCT331s_Smart_Home_Design.html` (project root): standalone offline copy of the design page. Three.js r147 + OrbitControls are inlined, so it needs no internet. It opens on variant B v2 with the team name plate.

- Hardware bring-up with the team: the LCD I2C (0x27 scanner), the buzzer alone, then LCD + MC-38 reed (D3) + buzzer (D6) together. The final sketch keeps the buzzer on continuously while the window is open and stops it as soon as the window closes; `ALWAYS_ARMED = true` until the toggle is wired.
- `wiring/Wiring_Guide.pdf` (14 pages, Egyptian Arabic) + `wiring/*.png`: breadboard explainer, then buzzer alone, LCD alone and the full system (11 numbered wires), with tables, test codes, the final code, troubleshooting and a pin summary. Generator: `wiring/src/diagrams.py` + `build_guide.py`.
