MahmoudH-22/Smart_Home/docs/history/2026-10/22-10-2026.md

# 22-10-2026

## Changed
- Team moved the window sensor to **D2** and the buzzer to **D8**. The wiring guide (`wiring/`), its diagrams and the simulation page pin map are updated to match. New planned map: D3 PIR, D6 light override button.
- Decision: keep `PIN_ARM` (D7) + `ALWAYS_ARMED`. The toggle is the "security mode" switch the brief requires; `ALWAYS_ARMED = true` is only for bench tests.

## Built
- `reports/Progress1_Report.pdf` (15 pages, English, simple words). It covers the summary/status, project overview, home structure (material, dimensions, joints, layout, CAD views, parts list, cutting sheets, material saving), the security system (components, sensor principle, wiring, flowchart, code ideas, tests, ESP8266 alert plan), problems and solutions, next steps, and appendices (code, pin map, files).
- State recorded in the report: house cut and assembled; LCD + MC-38 + buzzer working on the house; ESP8266 alert still in progress.
