MahmoudH-22/Smart_Home/docs/history/2026-10/25-10-2026.md

# 25-10-2026

## Built
- GitHub repository structure `mct331s-smart-home`: firmware / hardware / docs / tools, with README, BOM (receipt prices), pin map, .gitignore, .gitattributes.
- Firmware split into modules with the same behaviour as the working single-file sketch: `config.h`, `state.h`, `debounce.*`, `security.*`, `display.*`, and `smart_home.ino` (setup/loop only). Test sketches are in `firmware/tests/`.
- Generator scripts now use repo-relative paths (`tools/`, output in `build/`).

## Decided
- Repository is **private** (it contains the course brief) and teammates are added as collaborators.
- One module per system with begin()/update(); all pins in config.h; modules communicate only through `sys`.
